ataradov/current/README.md

# Current Profiler
This is a current profiler for low power devices (up to 100 mA).
Sorry, no detailed description at this time.

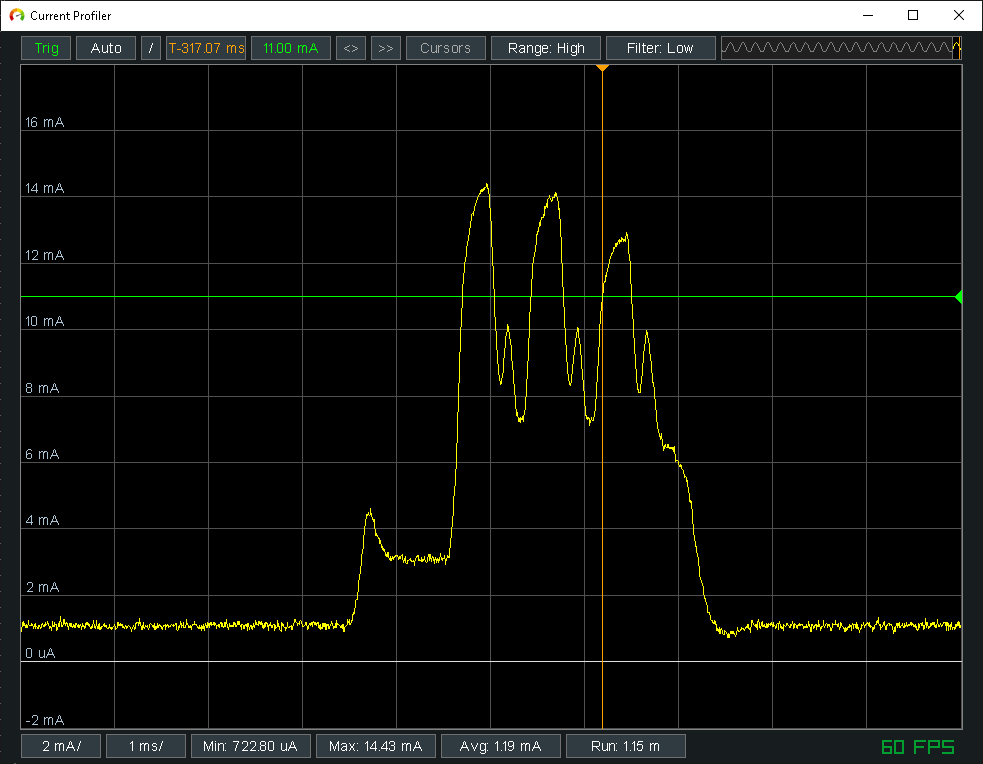
[picture p1: doc/current_gui.png]
GUI
