ataradov/current/sw/res/arial_14.png

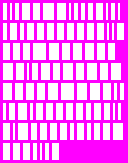
sw/res/arial_14.png
