ataradov/current/case/current.step

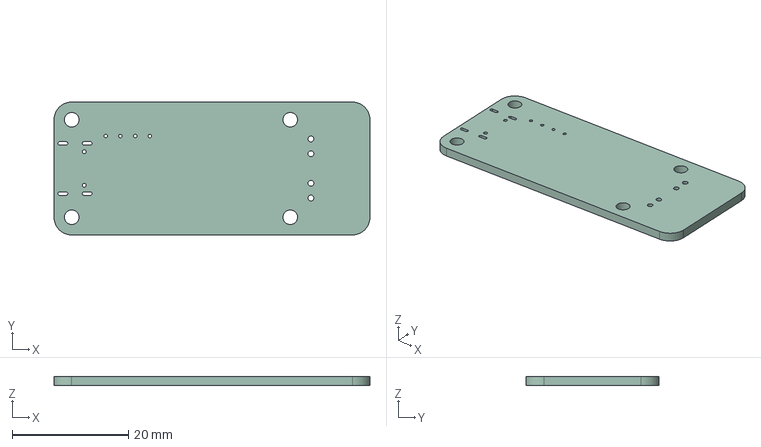
[picture p3: CAD file, 2025-11-03]
case/current.step
54.4 x 22.9 x 1.60 mm
