ataradov/current/(list of files, cad)

Other CAD files:
case/current.FCStd
