ataradov/current/hw/output/current.pdf

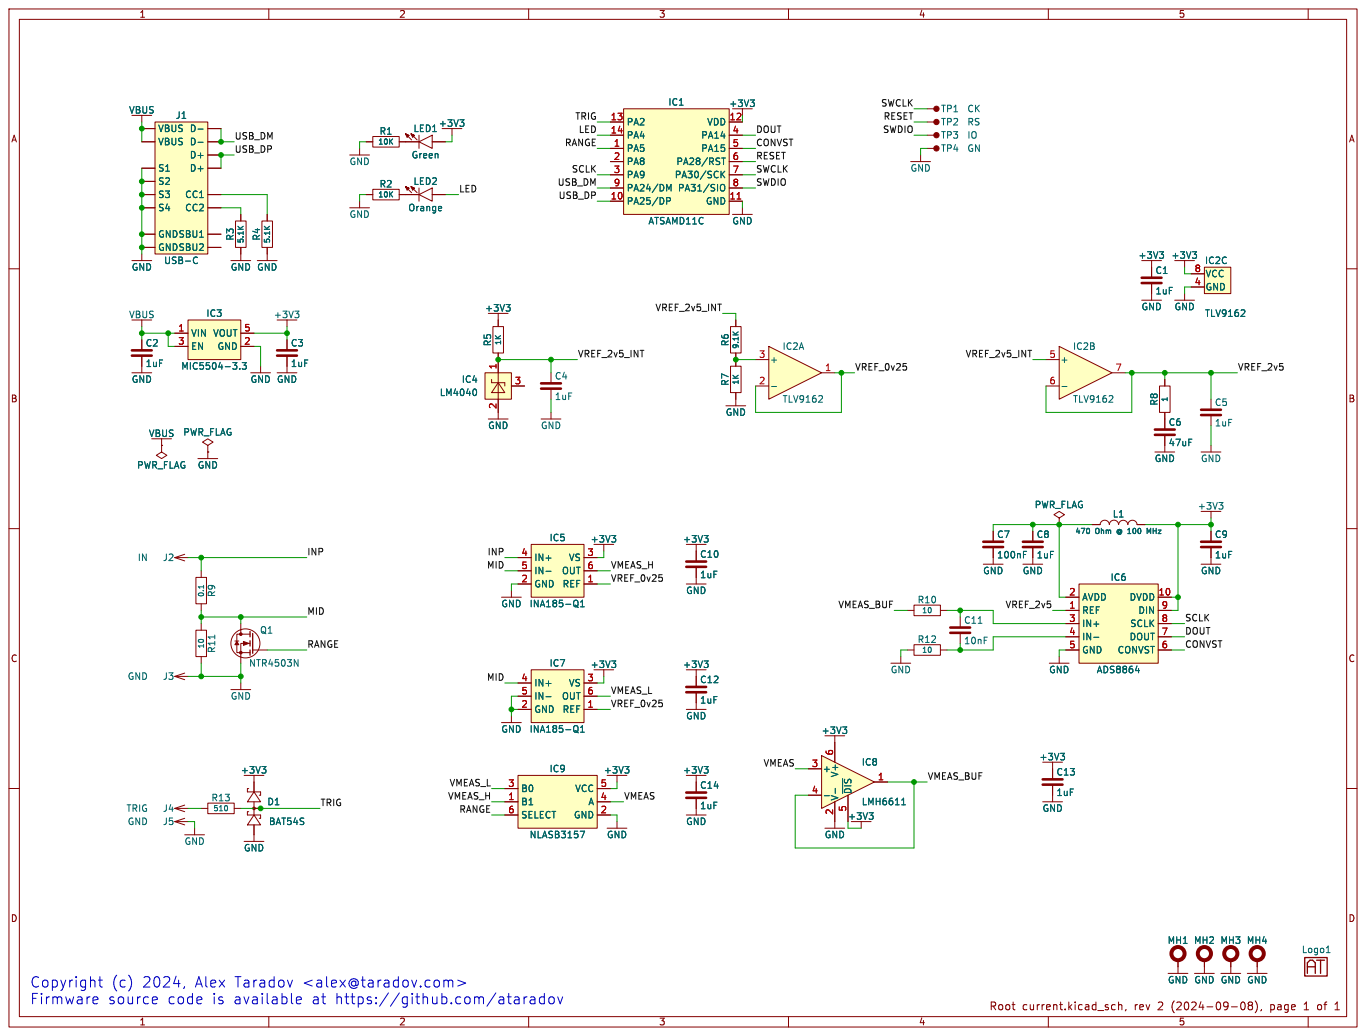
[picture p4: page 1]

SCLK USB_DP RANGE Copyright (c) 2024, Alex Taradov <alex@taradov.com>

470 Ohm @ 100 MHz GND GND GND
