ataradov/current/hw/current.kicad_pcb

## KiCad design hw/current.kicad_pcb (2025-11-03)

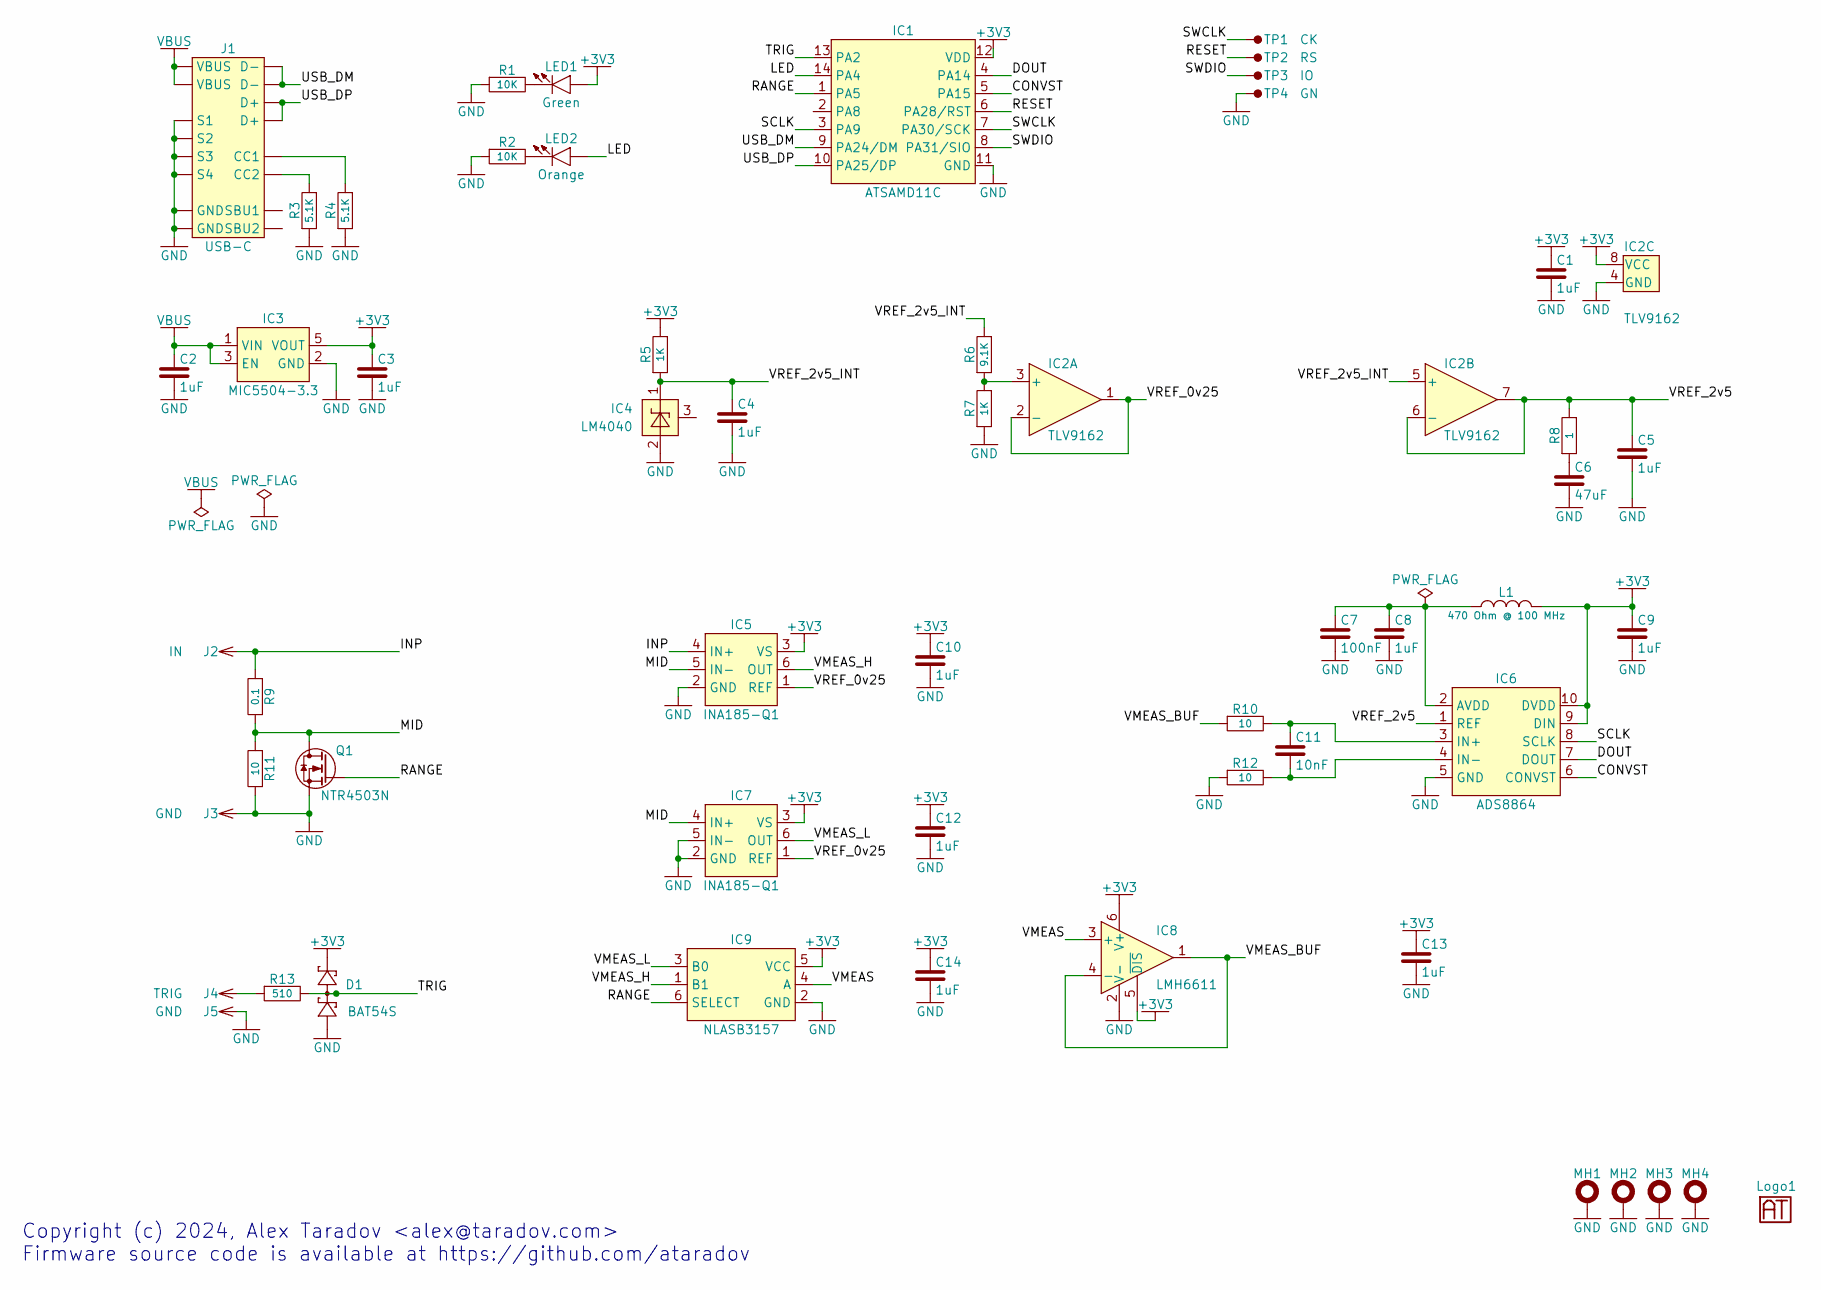
[picture p5: schematic current.kicad_sch]

Parts:
C1, C2, C3, C4, C5, C8, C9, C10, C12, C13, C14: 1uF; 0603
C6: 47uF; 0603
C7: 100nF; 0603
C11: 10nF; 0603
D1: BAT54S; SOT-23
IC1: ATSAMD11C; SOIC-14
IC2: TLV9162; SO-8
IC3: MIC5504-3.3; SOT-23-5
IC4: LM4040; SOT-23
IC5, IC7: INA185-Q1; SOT-363(SC-70-6)
IC6: ADS8864; MSOP-10-0.5mm
IC8: LMH6611; SOT-23-6
IC9: NLASB3157; SOT-363(SC-70-6)
J1: USB-C
J2: IN; Pin-2.54mm
J3, J5: GND; Pin-2.54mm
J4: TRIG; Pin-2.54mm
L1: 470 Ohm @ 100 MHz; 0603
LED1: Green; 0603_LED
LED2: Orange; 0603_LED
Logo1: Logo; Logo-Small
MH1, MH2, MH3, MH4: MH-2.5mm-4.0mm
Q1: NTR4503N; SOT-23
R1, R2: 10K; 0603
R3, R4: 5.1K; 0603
R5, R7: 1K; 0603
R6: 9.1K; 0603
R8: 1; 0603
R9: 0.1; 0805
R10, R12: 10; 0603
R11: 10; 0805
R13: 510; 0603
TP1: CK; TestPoint-1.27mm
TP2: RS; TestPoint-1.27mm
TP3: IO; TestPoint-1.27mm
TP4: GN; TestPoint-1.27mm

Connections:
+3V3: C1.2, C3.2, C9.2, C10.2, C12.2, C13.2, C14.2, D1.2, IC1.12 (VDD), IC2.8 (VCC), IC3.5 (VOUT), IC5.3 (VS), IC6.9 (DIN), IC6.10 (DVDD), IC7.3 (VS), IC8.5 (~DIS), IC8.6 (V+), IC9.5 (VCC), L1.2, LED1.1 (A), R5.2
/CONVST: IC1.5 (PA15), IC6.6 (CONVST)
/DOUT: IC1.4 (PA14), IC6.7 (DOUT)
/INP: IC5.4 (IN+), J2.1, R9.1
/LED: IC1.14 (PA4), LED2.1 (A)
/MID: IC5.5 (IN-), IC7.4 (IN+), Q1.3 (D), R9.2, R11.1
/RANGE: IC1.1 (PA5), IC9.6 (SELECT), Q1.1 (G)
/RESET: IC1.6 (PA28/RST), TP2.1
/SCLK: IC1.3 (PA9), IC6.8 (SCLK)
/SWCLK: IC1.7 (PA30/SCK), TP1.1
/SWDIO: IC1.8 (PA31/SIO), TP3.1
/TRIG: D1.3, IC1.13 (PA2), R13.2
/USB_DM: IC1.9 (PA24/DM), J1.D-1 (D-), J1.D-2 (D-)
/USB_DP: IC1.10 (PA25/DP), J1.D+1 (D+), J1.D+2 (D+)
/VMEAS: IC8.3 (+), IC9.4 (A)
/VMEAS_BUF: IC8.1, IC8.4 (-), R10.1
/VMEAS_H: IC5.6 (OUT), IC9.1 (B1)
/VMEAS_L: IC7.6 (OUT), IC9.3 (B0)
/VREF_0v25: IC2.1, IC2.2 (-), IC5.1 (REF), IC7.1 (REF)
/VREF_2v5: C5.2, IC2.6 (-), IC2.7, IC6.1 (REF), R8.2
/VREF_2v5_INT: C4.2, IC2.5 (+), IC4.1 (K), R5.1, R6.2
GND: C1.1, C2.1, C3.1, C4.1, C5.1, C6.1, C7.1, C8.1, C9.1, C10.1, C12.1, C13.1, C14.1, D1.1, IC1.11 (GND), IC2.4 (GND), IC3.2 (GND), IC4.2 (A), IC5.2 (GND), IC6.5 (GND), IC7.2 (GND), IC7.5 (IN-), IC8.2 (V-), IC9.2 (GND), J1.GND1 (GND), J1.GND2 (GND), J1.S1, J1.S2, J1.S3, J1.S4, J3.1, J5.1, MH1.1, MH2.1, MH3.1, MH4.1, Q1.2 (S), R1.1, R2.1, R3.1, R4.1, R7.1, R11.2, R12.1, TP4.1
unnamed: C6.2, R8.1
unnamed: IC2.3 (+), R6.1, R7.2
unnamed: C7.2, C8.2, IC6.2 (AVDD), L1.1
unnamed: C11.2, IC6.3 (IN+), R10.2
unnamed: C11.1, IC6.4 (IN-), R12.2
unnamed: J1.CC1, R4.2
unnamed: J1.CC2, R3.2
unnamed: J4.1, R13.1
unnamed: LED1.2 (K), R1.2
unnamed: LED2.2 (K), R2.2
VBUS: C2.2, IC3.1 (VIN), IC3.3 (EN), J1.VBUS1 (VBUS), J1.VBUS2 (VBUS)

Notes on the sheet:
Copyright (c) 2024, Alex Taradov <alex@taradov.com> Firmware source code is available at https://github.com/ataradov

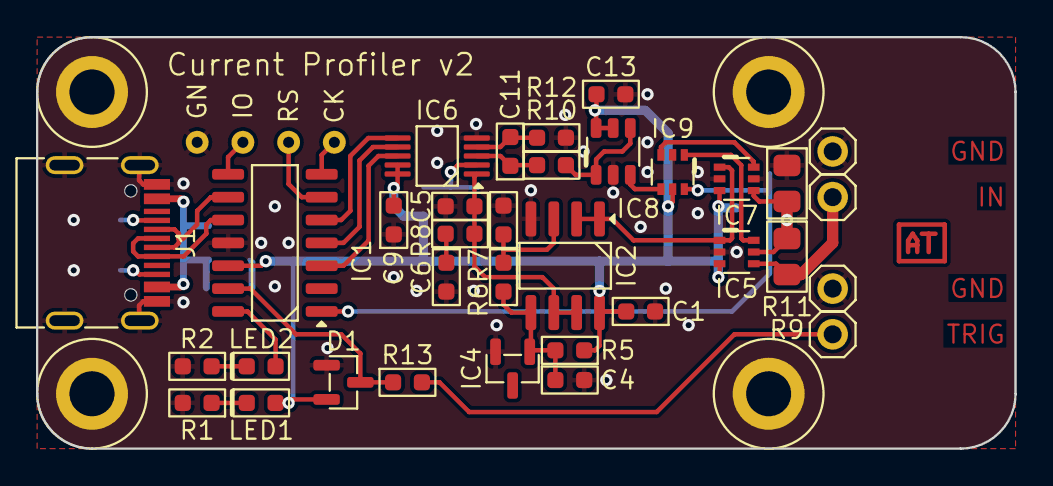
[picture p6: board current.kicad_pcb from above]

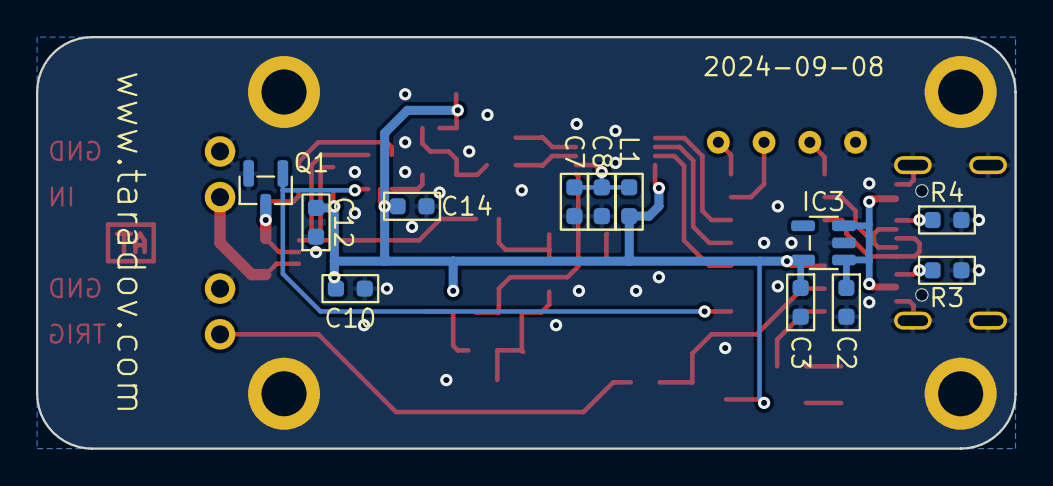
[picture p7: board current.kicad_pcb from below]

Board: 2 copper layers, 54.4 x 22.9 mm, 55 parts (12 on the bottom side), 33 nets.
